J1ng06/fall_detection_device/H14_Capstone_Project/Pedometer_application/README.md

### Android Step Sensors Example

Clone the project and run on your Nexus 5.

This sample project has been tested on Nexus 5 running Android KitKat.

It should also run with devices which have step sensors and running KitKat.

### License
-----------------------------------------------------------------------------------
Copyright 2013 Kumar Bibek

Licensed under the Apache License, Version 2.0 (the "License");<br />
you may not use this file except in compliance with the License.<br />
You may obtain a copy of the License at
   
[http://www.apache.org/licenses/LICENSE-2.0](http://www.apache.org/licenses/LICENSE-2.0)
	
Unless required by applicable law or agreed to in writing, software<br />
distributed under the License is distributed on an "AS IS" BASIS,<br />
WITHOUT WARRANTIES OR CONDITIONS OF ANY KIND, either express or implied.<br />
See the License for the specific language governing permissions and<br />
limitations under the License.
