J1ng06/fall_detection_device/H14_Capstone_Project/Pedometer_application/ic_launcher-web.png

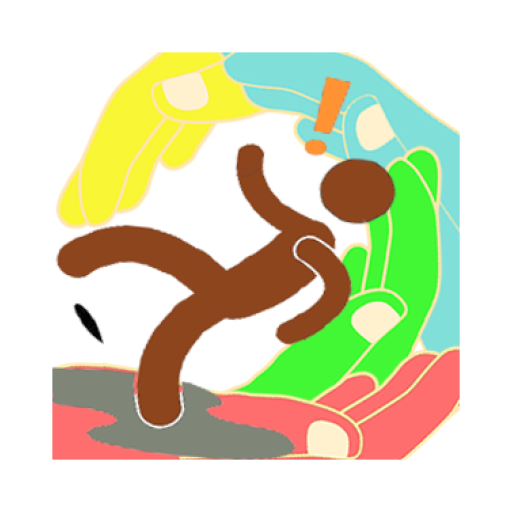
H14_Capstone_Project/Pedometer_application/ic_launcher-web.png
